leungkimming/ehome/doc/IMG_5448.jpg

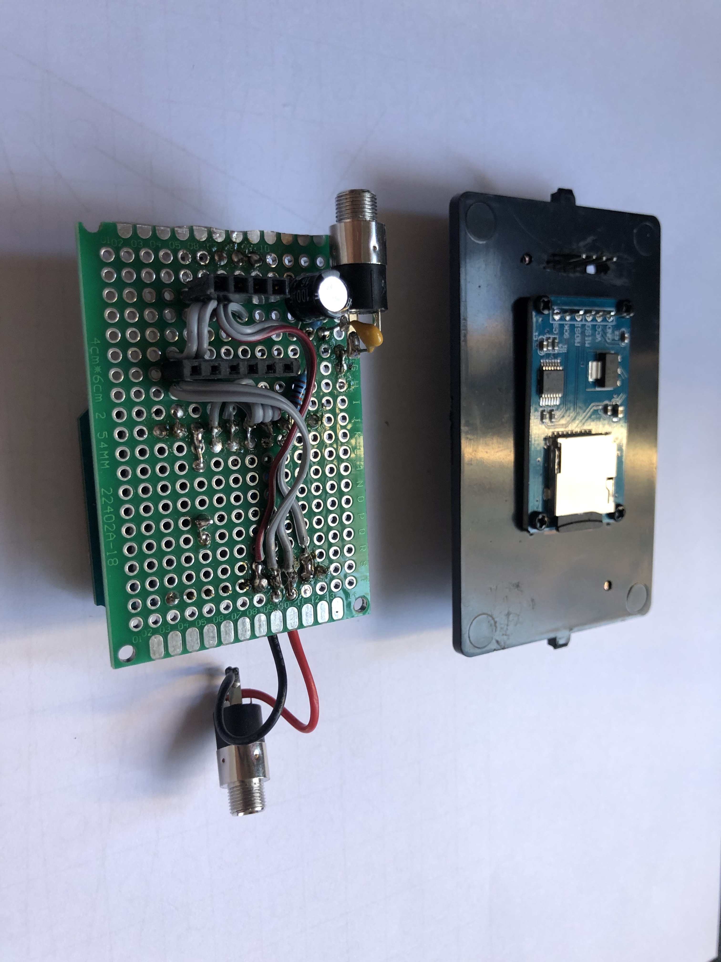
doc/IMG_5448.jpg
