leungkimming/ehome/doc/IMG_5464.jpg

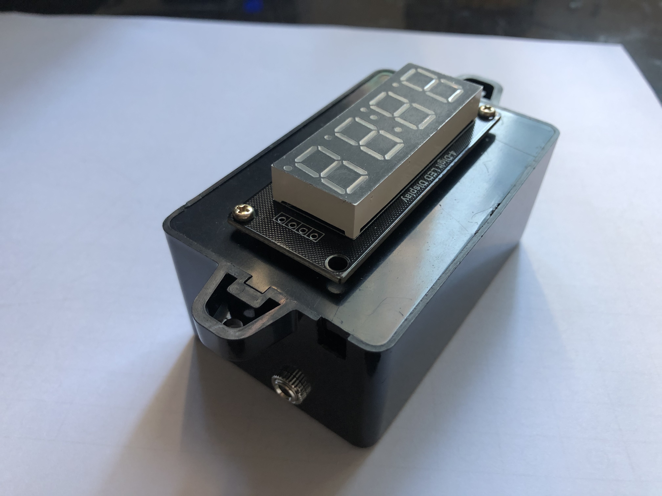
doc/IMG_5464.jpg
