leungkimming/ehome/doc/IMG_5472.JPG

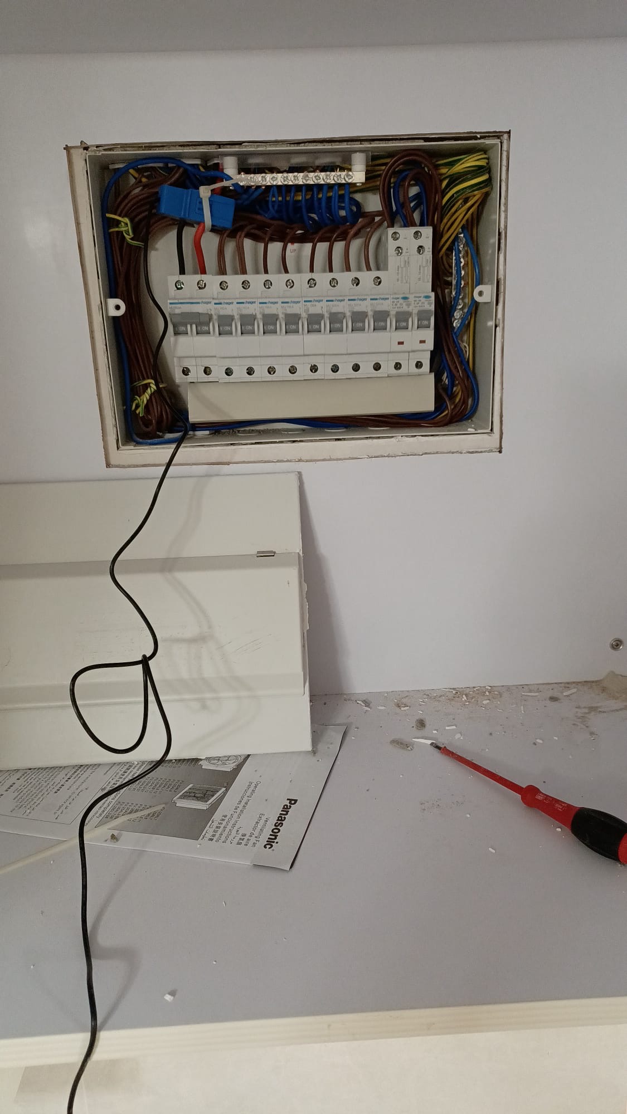
doc/IMG_5472.JPG
