leungkimming/ehome/doc/IMG_9110.jpg

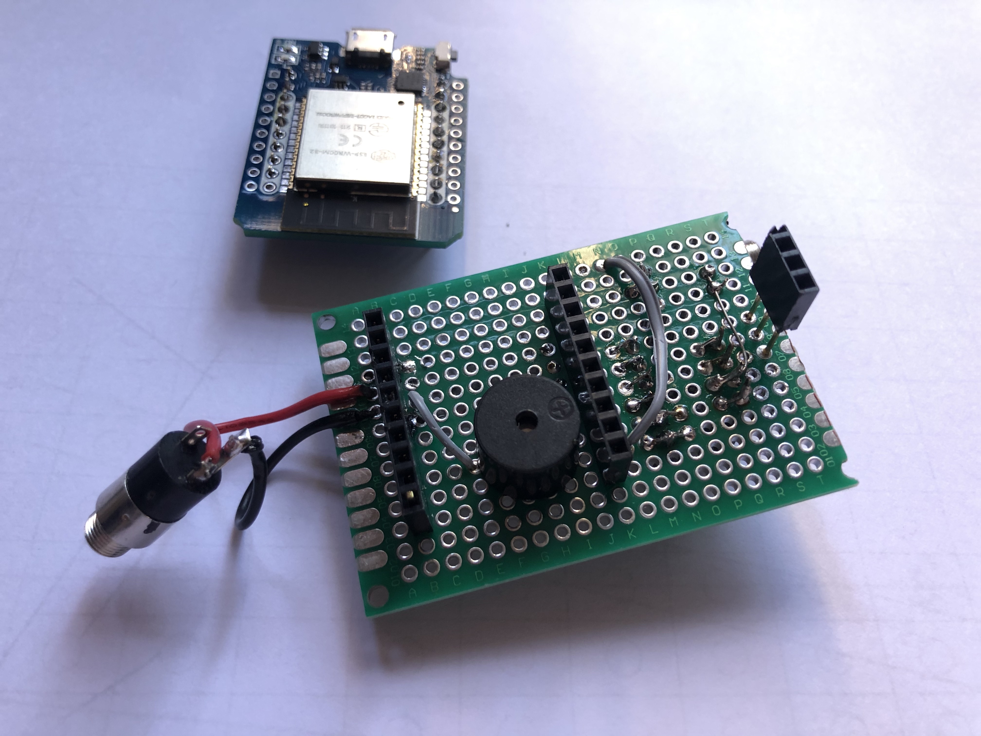
doc/IMG_9110.jpg
